pcfx-devel/PC-FX_devcart/enclosure/FX_Dev_Top.stl

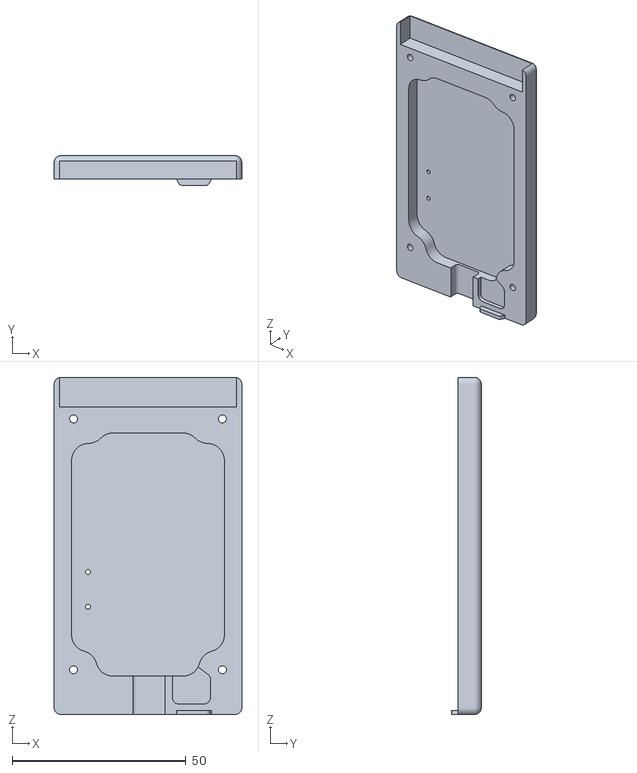
[picture p2: CAD file, 2025-01-13]
enclosure/FX_Dev_Top.stl
54.0 x 8.54 x 96.9
