pcfx-devel/PC-FX_devcart/enclosure/FX_Dev_Bottom.stl

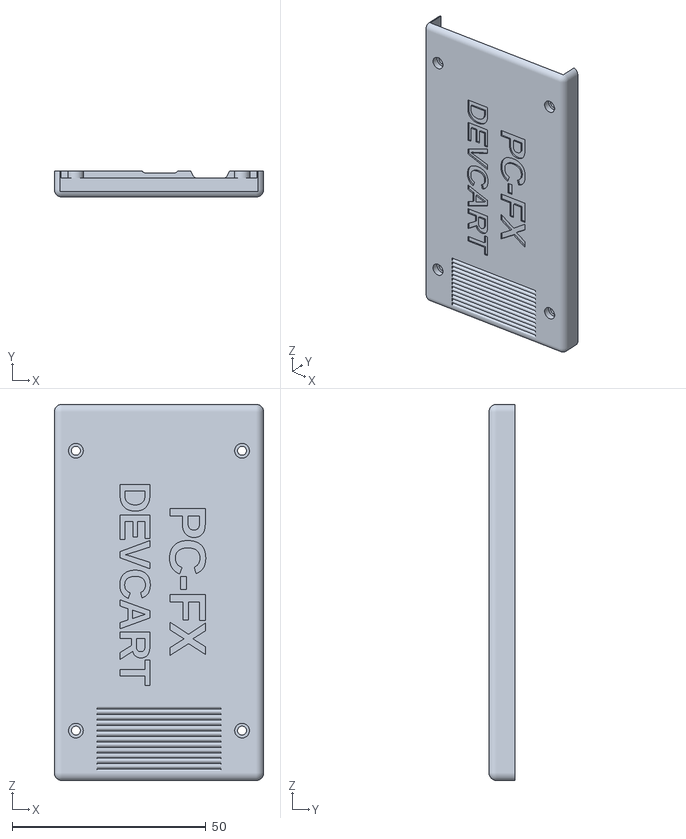
[picture p3: CAD file, 2025-01-13]
enclosure/FX_Dev_Bottom.stl
54.0 x 6.75 x 96.9
