pcfx-devel/PC-FX_devcart/(commit log)

2024-12-22 Minor tweaks to case model
    [FXDev_Case.scad, FX_Dev_Bottom.stl, FX_Dev_Top.stl]
2025-01-13 Minor changes to the board (labels, LED brightness resistors)
    [bom.csv]
2025-01-13 Minor changes to the case (LED overhang for greater visibility)
    [FXDev_Case.scad, FX_Dev_Bottom.stl, FX_Dev_Top.stl]
